JK-Custom-Keyboards/jk206/README.md

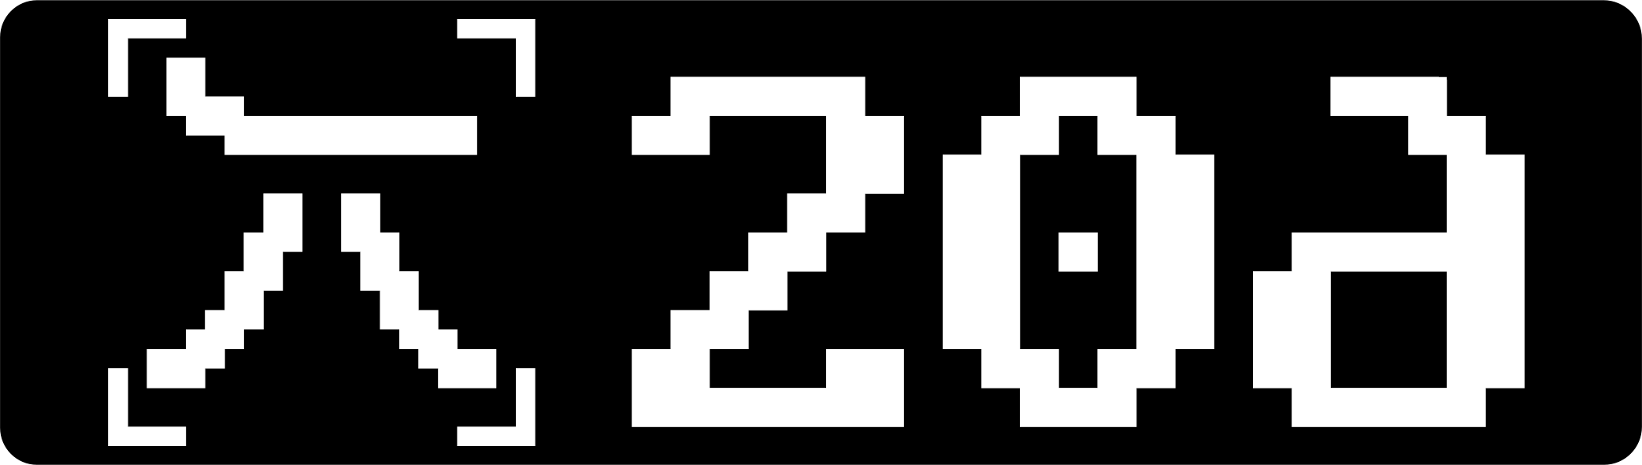
[picture p1: assets/images/logo_jk206_wob.png]
Logo of the project


<h2 align="Left"> English </h2>

This project consists of a mechanical ortolinear keyboard design that is capable of being used for both a macropad and a 50% keyboard.

This is achieved through a modular design PCB that can be used by itself to mount a macropad with up to 20 keys (5 of them can be exchanged for encoders); while with three PCBs you can mount a keyboard with up to 60 keys (3 of them can be encoders)

The project firmware is in QMK and the source code can be found here <a href="https://github.com/JK-Custom-Keyboards/qmk_firmware/tree/master/keyboards/jk206">here</a>. The development board used for the project is the Raspberry Pi Pico, but should work any RP2040 board with the same pinout.

If you want to build your own JK206, go to the [guide](/Guide/guide_eng.md), where there will be the step-by-step to assemble and configure it

<strong>Note:</strong> If you just want to assemble your own JK206 and don't plan to modify anything of the PCB design, you don't need to touch the KiCAD files, directly use the Gerbers as the guide says

<h2 align="Left"> Español </h2>

Este proyecto consiste en un diseño de teclado mecánico ortolineal que es capaz de utilizarse tanto para un macropad como para un teclado 50%. 

Esto se consigue mediante una PCB de diseño modular que se puede usar por si misma para montar un macropad de hasta 20 teclas (5 de ellas se pueden cambiar por encoders); mientras que con tres PCBs se puede montar un teclado de hasta 60 teclas (3 de ellas pueden ser encoders)

El firmware del proyecto está en QMK y el código fuente puede ser encontrado <a href="https://github.com/JK-Custom-Keyboards/qmk_firmware/tree/master/keyboards/jk206">aquí</a>. La placa de desarrollo usada en el proyecto es la Raspberry Pi Pico, pero debería funcionar cualquier placa RP2040 con el mismo pinout.

Si quieres armar tu propio JK206, entra en la [guía](/Guide/guide_eng.md), donde estará el paso a paso para ensamblarlo y configurarlo 

<strong>Nota:</strong> Si solo quieres montar tu propio JK206 y no piensan modificar nada del diseño de la PCB , no necesitas tocar los archivos de KiCAD, usa directamente los Gerbers como dice la guía

<h1 align="Left"> Photos / Fotos </h1>
