JK-Custom-Keyboards/jk206/Cases/Sandwich-Case/Keyboard/readme.md

<h2 align="Left"> English </h2>

These are the SVG designs of the acrylic pieces needed for the Sandwich-Case type assembly of the keyboard. These pieces are designed to measure 1.5mm thick and can be made at any acrylic cutter shop by simply taking the SVG.

<h2 align="Left"> Español </h2>

Estos son los diseños en SVG de las piezas acrílicas necesarias para el montaje tipo Sandwich-Case del teclado. Estas piezas están pensadas para medir 1.5mm de grosor y se pueden mandar a hacer en cualquier local de venta y corte de acrilicos simplemente llevando el SVG
