JK-Custom-Keyboards/jk206/KiCAD_Design/JK206.kicad_pcb

## KiCad design KiCAD_Design/JK206.kicad_pcb (2026-08-22)

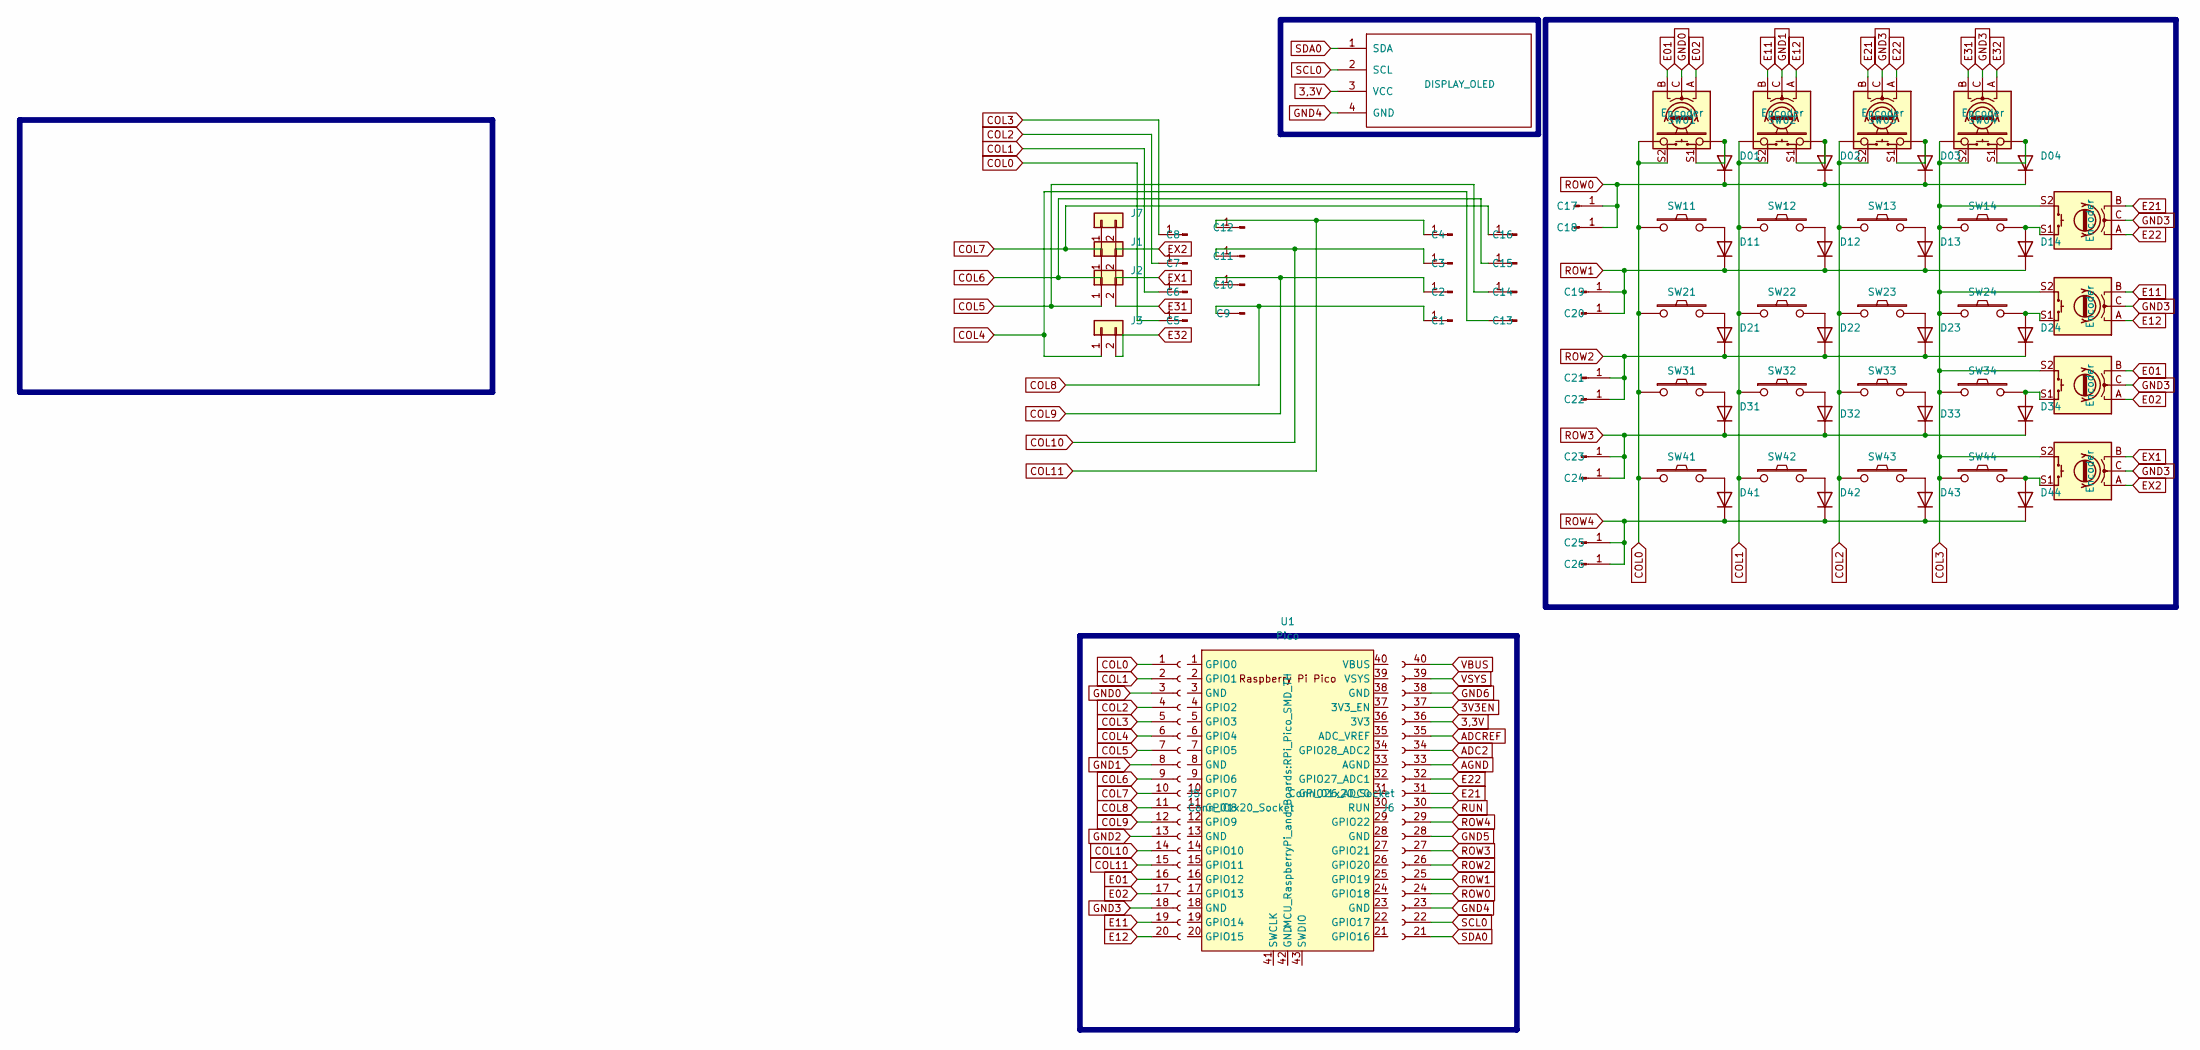
[picture p2: schematic JK206.kicad_sch]

Parts:
C1, C2, C3, C4, C5, C6, C7, C8, C9, C10, C11, C12, C13, C14, C15, C16: Conn_01x01_Pin; Pin_D1.0mm_L10.0mm
C17, C18, C19, C20, C21, C22, C23, C24, C25, C26: Conn_01x01_Pin; SolderWire-0.1sqmm_1x01_D0.4mm_OD1mm
D01, D02, D03, D04, D11, D12, D13, D14, D21, D22, D23, D24, D31, D32, D33, D34, D41, D42, D43, D44: 1N4148; D_DO-35_SOD27_P7.62mm_Horizontal
J1, J2, J3, J7: Connector_Generic_Conn_01x02; PinSocket_1x02_P2.54mm_Vertical
J5, J6: Conn_01x20_Socket; PinSocket_1x20_P2.54mm_Vertical
OL1: DISPLAY_OLED; 128x64OLED
SW01, SW02, SW03, SW04, SW11, SW12, SW13, SW14, SW21, SW22, SW23, SW24, SW31, SW32, SW33, SW34, SW41, SW42, SW43, SW44: SW_PUSH; CherryMX_Hotswap
SW5, SW18, SW19, SW20, SW25, SW26, SW27, SW28: Encoder; RotaryEncoder_Alps_EC11E-Switch_Vertical_H20mm
U1: Pico; RPi_Pico_SMD_TH

Connections:
3,3V: J6.36 (Pin_16), OL1.3 (VCC); also elsewhere on the board
3V3EN: J6.37 (Pin_17)
ADC2: J6.34 (Pin_14)
ADCREF: J6.35 (Pin_15)
AGND: J6.33 (Pin_13)
COL0: C5.1, J5.1, SW01.1, SW5.S2, SW11.1, SW21.1, SW31.1, SW41.1
COL1: C6.1, J5.2, SW02.1, SW12.1, SW18.S2, SW22.1, SW32.1, SW42.1
COL2: C7.1, J5.4, SW03.1, SW13.1, SW19.S2, SW23.1, SW33.1, SW43.1
COL3: C8.1, J5.5, SW04.1, SW14.1, SW20.S2, SW24.1, SW25.S2, SW26.S2, SW27.S2, SW28.S2, SW34.1, SW44.1
COL4: C13.1, J3.1, J5.6
COL5: C14.1, J2.1, J5.7
COL6: C15.1, J1.1, J5.9
COL7: C16.1, J5.10, J7.1
COL8: C1.1, C9.1, J5.11
COL9: C2.1, C10.1, J5.12
COL10: C3.1, C11.1, J5.14
COL11: C4.1, C12.1, J5.15
E01: J5.16, SW5.B, SW27.B
E02: J5.17, SW5.A, SW27.A
E11: J5.19, SW18.B, SW26.B
E12: J5.20, SW18.A, SW26.A
E21: J6.31 (Pin_11), SW19.B, SW25.B
E22: J6.32 (Pin_12), SW19.A, SW25.A
E31: J2.2, SW20.B
E32: J3.2, SW20.A
EX1: J1.2, SW28.B
EX2: J7.2, SW28.A
GND0: J5.3, SW5.C
GND1: J5.8, SW18.C
GND2: J5.13
GND3: J5.18, SW19.C, SW20.C, SW25.C, SW26.C, SW27.C, SW28.C
GND4: J6.23 (Pin_3), OL1.4 (GND); also elsewhere on the board
GND5: J6.28 (Pin_8)
GND6: J6.38 (Pin_18)
unnamed: D01.2 (A), SW01.2, SW5.S1
unnamed: D02.2 (A), SW02.2, SW18.S1
unnamed: D03.2 (A), SW03.2, SW19.S1
unnamed: D04.2 (A), SW04.2, SW20.S1
unnamed: D11.2 (A), SW11.2
unnamed: D12.2 (A), SW12.2
unnamed: D13.2 (A), SW13.2
unnamed: D14.2 (A), SW14.2, SW25.S1
unnamed: D21.2 (A), SW21.2
unnamed: D22.2 (A), SW22.2
unnamed: D23.2 (A), SW23.2
unnamed: D24.2 (A), SW24.2, SW26.S1
unnamed: D31.2 (A), SW31.2
unnamed: D32.2 (A), SW32.2
unnamed: D33.2 (A), SW33.2
unnamed: D34.2 (A), SW27.S1, SW34.2
unnamed: D41.2 (A), SW41.2
unnamed: D42.2 (A), SW42.2
unnamed: D43.2 (A), SW43.2
unnamed: D44.2 (A), SW28.S1, SW44.2
ROW0: C17.1, C18.1, D01.1 (K), D02.1 (K), D03.1 (K), D04.1 (K), J6.24 (Pin_4)
ROW1: C19.1, C20.1, D11.1 (K), D12.1 (K), D13.1 (K), D14.1 (K), J6.25 (Pin_5)
ROW2: C21.1, C22.1, D21.1 (K), D22.1 (K), D23.1 (K), D24.1 (K), J6.26 (Pin_6)
ROW3: C23.1, C24.1, D31.1 (K), D32.1 (K), D33.1 (K), D34.1 (K), J6.27 (Pin_7)
ROW4: C25.1, C26.1, D41.1 (K), D42.1 (K), D43.1 (K), D44.1 (K), J6.29 (Pin_9)
RUN: J6.30 (Pin_10)
SCL0: J6.22 (Pin_2), OL1.2 (SCL); also elsewhere on the board
SDA0: J6.21 (Pin_1), OL1.1 (SDA); also elsewhere on the board
VBUS: J6.40 (Pin_20)
VSYS: J6.39 (Pin_19)

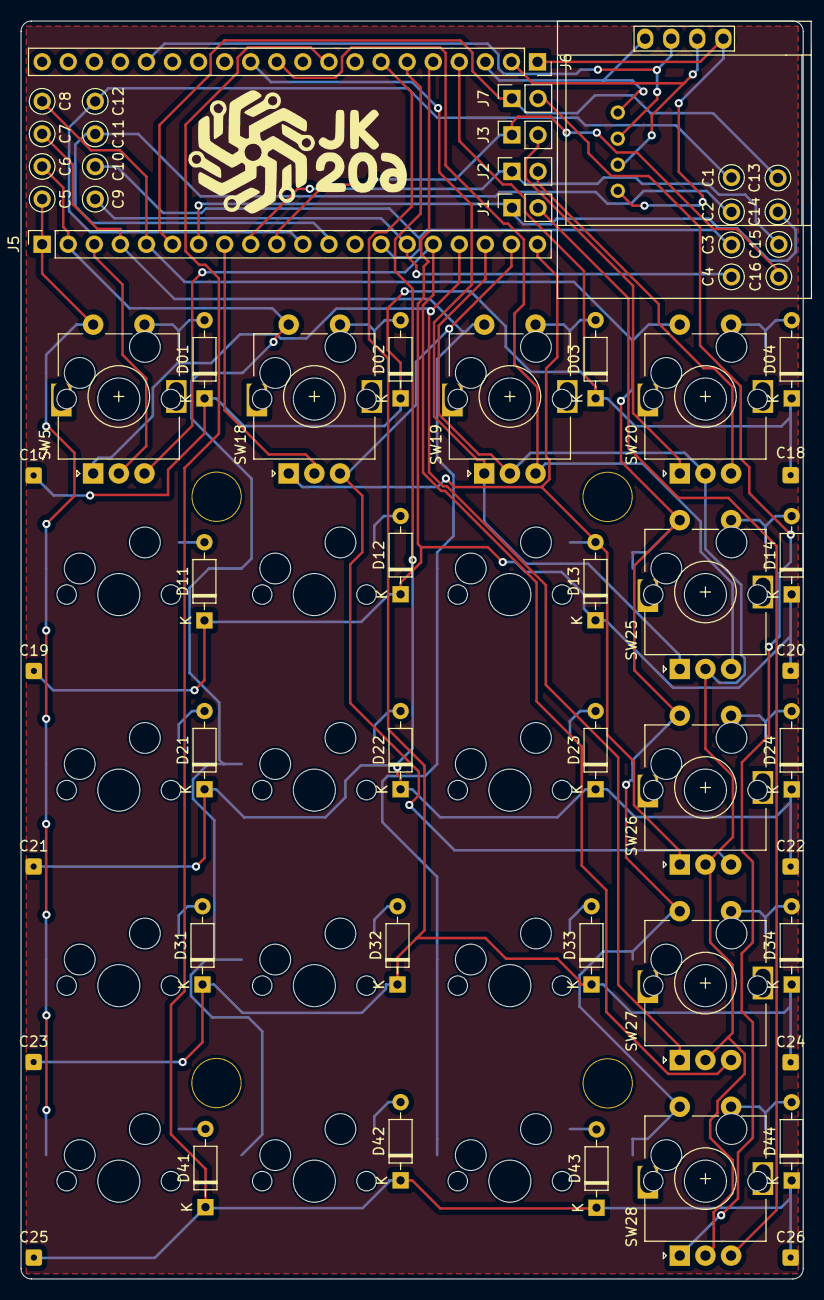
[picture p3: board JK206.kicad_pcb from above]

Board: 2 copper layers, 76.2 x 122.6 mm, 82 parts (0 on the bottom side), 54 nets.

Other parts of the board:
OL1#2: DISPLAY_OLED; 128x64OLED

Their connections:
3,3V: OL1#2.2 (SCL); also elsewhere on the board
GND4: OL1#2.1 (SDA); also elsewhere on the board
SCL0: OL1#2.3 (VCC); also elsewhere on the board
SDA0: OL1#2.4 (GND); also elsewhere on the board
