JK-Custom-Keyboards/jk206/(commit log)

2026-08-22 add kicad project and gerbers
    [JK206.kicad_pcb, JK206.kicad_sch]
2026-08-22 fix readme description for keyboard sandwich case
